jacksonjared/tu-5-Replacement/referenceDocs/tu5SchematicDiagram.png

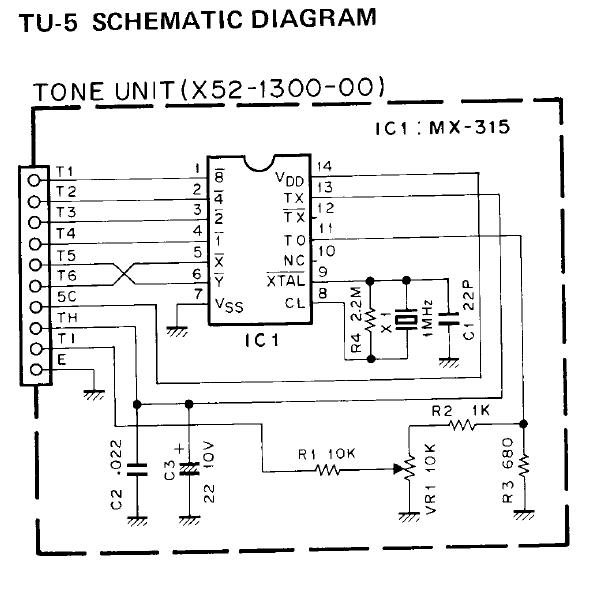
referenceDocs/tu5SchematicDiagram.png
