jacksonjared/tu-5-Replacement/tu5Replacement.kicad/tu9Replacement.kicad_sch

## KiCad design tu5Replacement.kicad/tu9Replacement.kicad_sch (2022-01-25)

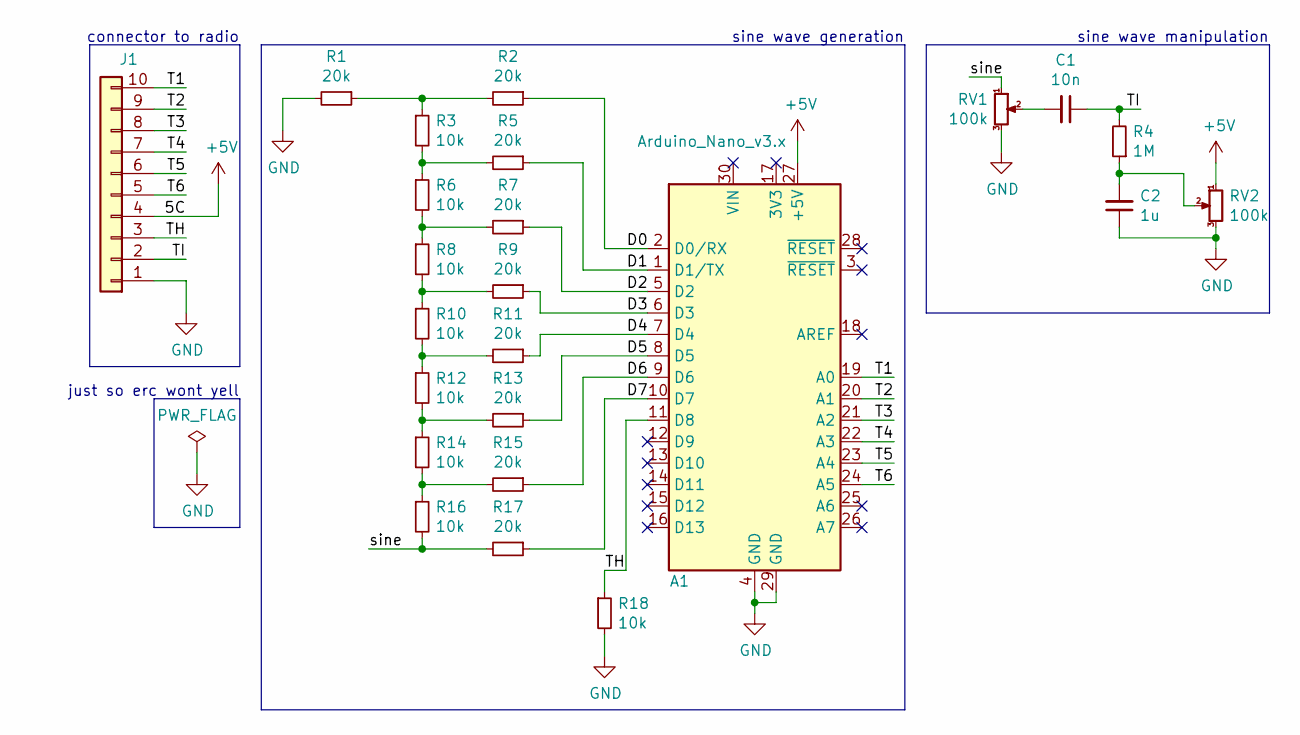
[picture p5: schematic tu9Replacement.kicad_sch]

Parts:
A1: Arduino_Nano_v3.x
C1: 10n
C2: 1u
J1: Conn_01x10
R1, R2, R5, R7, R9, R11, R13, R15, R17: 20k
R3, R6, R8, R10, R12, R14, R16, R18: 10k
R4: 1M
RV1, RV2: 100k

Connections:
+5V: A1.27 (+5V), J1.4, RV2.1
D0: A1.2 (D0/RX), R2.1
D1: A1.1 (D1/TX), R5.1
D2: A1.5 (D2), R7.1
D3: A1.6 (D3), R9.1
D4: A1.7 (D4), R11.1
D5: A1.8 (D5), R13.1
D6: A1.9 (D6), R15.1
D7: A1.10 (D7), R17.1
GND: A1.4 (GND), A1.29 (GND), C2.1, J1.1, R1.2, R18.2, RV1.3, RV2.3
unnamed: C1.2, RV1.2
unnamed: C2.2, R4.1, RV2.2
unnamed: R1.1, R2.2, R3.1
unnamed: R3.2, R5.2, R6.1
unnamed: R6.2, R7.2, R8.1
unnamed: R8.2, R9.2, R10.1
unnamed: R10.2, R11.2, R12.1
unnamed: R12.2, R13.2, R14.1
unnamed: R14.2, R15.2, R16.1
T1: A1.19 (A0), J1.10
T2: A1.20 (A1), J1.9
T3: A1.21 (A2), J1.8
T4: A1.22 (A3), J1.7
T5: A1.23 (A4), J1.6
T6: A1.24 (A5), J1.5
TH: A1.11 (D8), J1.3, R18.1
TI: C1.1, J1.2, R4.2
sine: R16.2, R17.2, RV1.1

Notes on the sheet:
sine wave generation
just so erc wont yell
connector to radio
sine wave manipulation
