jacksonjared/tu-5-Replacement/(commit log)

2022-01-25 Initial upload of current progress
    [tu9Replacement.kicad_pcb, tu9Replacement.kicad_sch]
2022-02-16 parity with local work
    [tu9Replacement.kicad_pcb, tu9Replacement.kicad_sch]
